movuino/maxiMotorShield/Hardware/MotorShieldV0.99.3-3.brd

## EAGLE design Hardware/MotorShieldV0.99.3-3.brd (2020-12-16)

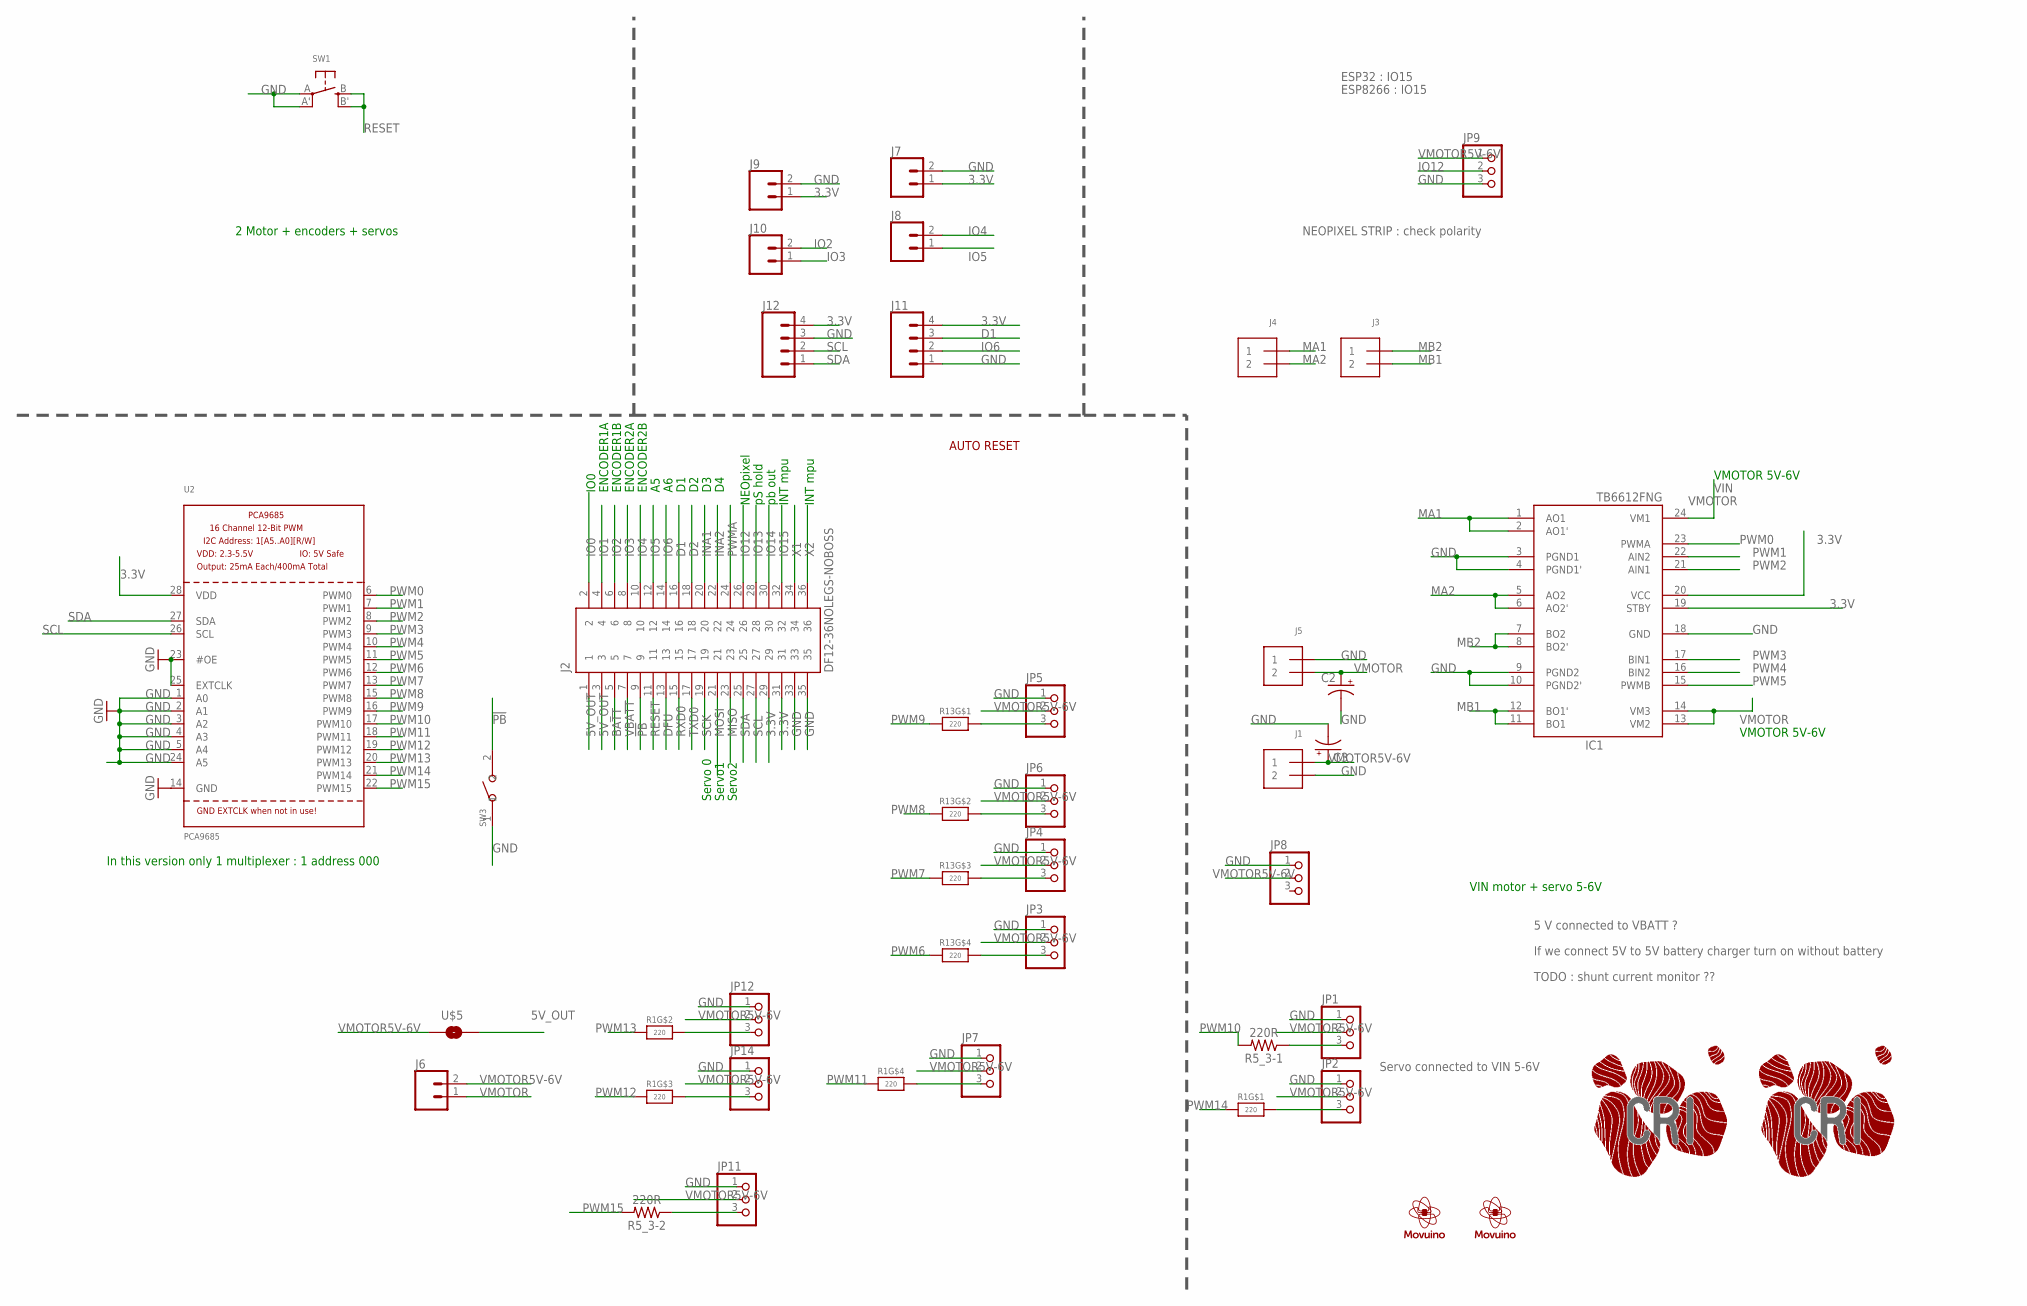
[picture p1: schematic MotorShieldV0.99.3-3.sch]

Parts:
C2, C3: CPOL-USE3.5-8; E3,5-8
IC1: TB6612FNG; SSOP24
J1, J3, J4, J5: TERMBLOCK_1X2; TERMBLOCK_1X2-3.5MM
J2: DF12-36NOLEGS-NOBOSS; DF12-36-DP-NL-NB
J6, J7, J8, J9, J10: CONN_02; 1X02
J11, J12: CONN_04; 1X04
JP1, JP2, JP3, JP4, JP5, JP6, JP7, JP8, JP9, JP11, JP12, JP14: PINHD-1X3; 1X03
R1, R13: 220; RESPACK_4X0603
R5_3-1, R5_3-2: 220R; R0402-SMALL-TDOCU
SW1: SWITCH_TACT_SMT; EVQ-Q2
SW3: DIP-BUTTON(2P-6.0X3.0X4.3MM)-TS-1101F; SW2-5.0-6.0X3.0X4.3MM
U2: PCA9685; TSSOP28
U$1: LOGO_MOVUINOTOP; LOGO_MOVUINO_BMP_10MM
U$2, U$3: LOGO-CRI-NEW-110MM-BOTTOM-SILK; LOGO_CRI-NEW-BMP10MM-BOTTOM
U$5: 0402-JUMPERCLOSED-DEFAULT; 0402-JUMPER-CLOSED
U$8: LOGO_MOVUINOBOTTOM_11MM; LOGO_MOVUINO_BMP_11MM-BOTTOM

Connections:
3.3V: IC1.19 (STBY), IC1.20 (VCC), J2.29, J2.31, J7.1, J9.1, J11.4, J12.4, U2.28 (VDD)
5V_OUT: J2.1, J2.3, U$5.2
!PB!: J2.9, SW3.2
BATT: J2.5
D1: J2.16, J11.3
D2: J2.18
DFU: J2.13
GND: C2.-, C3.-, IC1.3 (PGND1), IC1.4 (PGND1'), IC1.9 (PGND2), IC1.10 (PGND2'), IC1.18 (GND), J1.2, J2.33, J2.35, J5.1, J7.2, J9.2, J11.1, J12.3, JP1.1, JP2.1, JP3.1, JP4.1, JP5.1, JP6.1, JP7.1, JP8.1, JP9.3, JP11.1, JP12.1, JP14.1, SW1.A, SW1.A' (P1), SW3.1, U2.1 (A0), U2.2 (A1), U2.3 (A2), U2.4 (A3), U2.5 (A4), U2.14 (GND), U2.23 (#OE), U2.24 (A5), U2.25 (EXTCLK)
INA1: J2.20
INA2: J2.22
IO0: J2.2
IO1: J2.4
IO2: J2.6, J10.2
IO3: J2.8, J10.1
IO4: J2.10, J8.2
IO5: J2.12, J8.1
IO6: J2.14, J11.2
IO12: J2.26, JP9.2
IO13: J2.28
IO14: J2.30
IO15: J2.32
MA1: IC1.1 (AO1), IC1.2 (AO1'), J4.1
MA2: IC1.5 (AO2), IC1.6 (AO2'), J4.2
MB1: IC1.11 (BO1), IC1.12 (BO1'), J3.2
MB2: IC1.7 (BO2), IC1.8 (BO2'), J3.1
MISO: J2.23
MOSI: J2.21
unnamed: JP5.3, R13.8 (2)
unnamed: JP6.3, R13.7 (2)
unnamed: JP4.3, R13.6 (2)
unnamed: JP3.3, R13.5 (2)
unnamed: JP1.3, R5_3-1.1
unnamed: JP2.3, R1.8 (2)
unnamed: JP12.3, R1.7 (2)
unnamed: JP14.3, R1.6 (2)
unnamed: JP7.3, R1.5 (2)
unnamed: JP11.3, R5_3-2.1
PWM0: IC1.23 (PWMA), U2.6 (PWM0)
PWM1: IC1.22 (AIN2), U2.7 (PWM1)
PWM2: IC1.21 (AIN1), U2.8 (PWM2)
PWM3: IC1.17 (BIN1), U2.9 (PWM3)
PWM4: IC1.16 (BIN2), U2.10 (PWM4)
PWM5: IC1.15 (PWMB), U2.11 (PWM5)
PWM6: R13.4 (1), U2.12 (PWM6)
PWM7: R13.3 (1), U2.13 (PWM7)
PWM8: R13.2 (1), U2.15 (PWM8)
PWM9: R13.1, U2.16 (PWM9)
PWM10: R5_3-1.2, U2.17 (PWM10)
PWM11: R1.4 (1), U2.18 (PWM11)
PWM12: R1.3 (1), U2.19 (PWM12)
PWM13: R1.2 (1), U2.20 (PWM13)
PWM14: R1.1, U2.21 (PWM14)
PWM15: R5_3-2.2, U2.22 (PWM15)
PWMA: J2.24
RESET: J2.11, SW1.B (S), SW1.B' (S1)
RXD0: J2.15
SCK: J2.19
SCL: J2.27, J12.2, U2.26 (SCL)
SDA: J2.25, J12.1, U2.27 (SDA)
TXD0: J2.17
VBATT: J2.7
VMOTOR: C2.+, IC1.13 (VM2), IC1.14 (VM3), IC1.24 (VM1), J5.2, J6.1
VMOTOR5V-6V: C3.+, J1.1, J6.2, JP1.2, JP2.2, JP3.2, JP4.2, JP5.2, JP6.2, JP7.2, JP8.2, JP9.1, JP11.2, JP12.2, JP14.2, U$5.1
X1: J2.34
X2: J2.36

Notes on the sheet:
AUTO RESET
5 V connected to VBATT ?
If we connect 5V to 5V battery charger turn on without battery
VIN
VMOTOR 5V-6V
Servo connected to VIN 5-6V
TODO : shunt current monitor ??
ENCODER2B
ENCODER2A
ENCODER1B
ENCODER1A
IO0
NEOpixel
pS hold
pb out
INT mpu
Servo 0
Servo1
Servo2
In this version only 1 multiplexer : 1 address 000
2 Motor + encoders + servos
VIN motor + servo 5-6V
NEOPIXEL STRIP : check polarity
ESP8266 : IO15
ESP32 : IO15

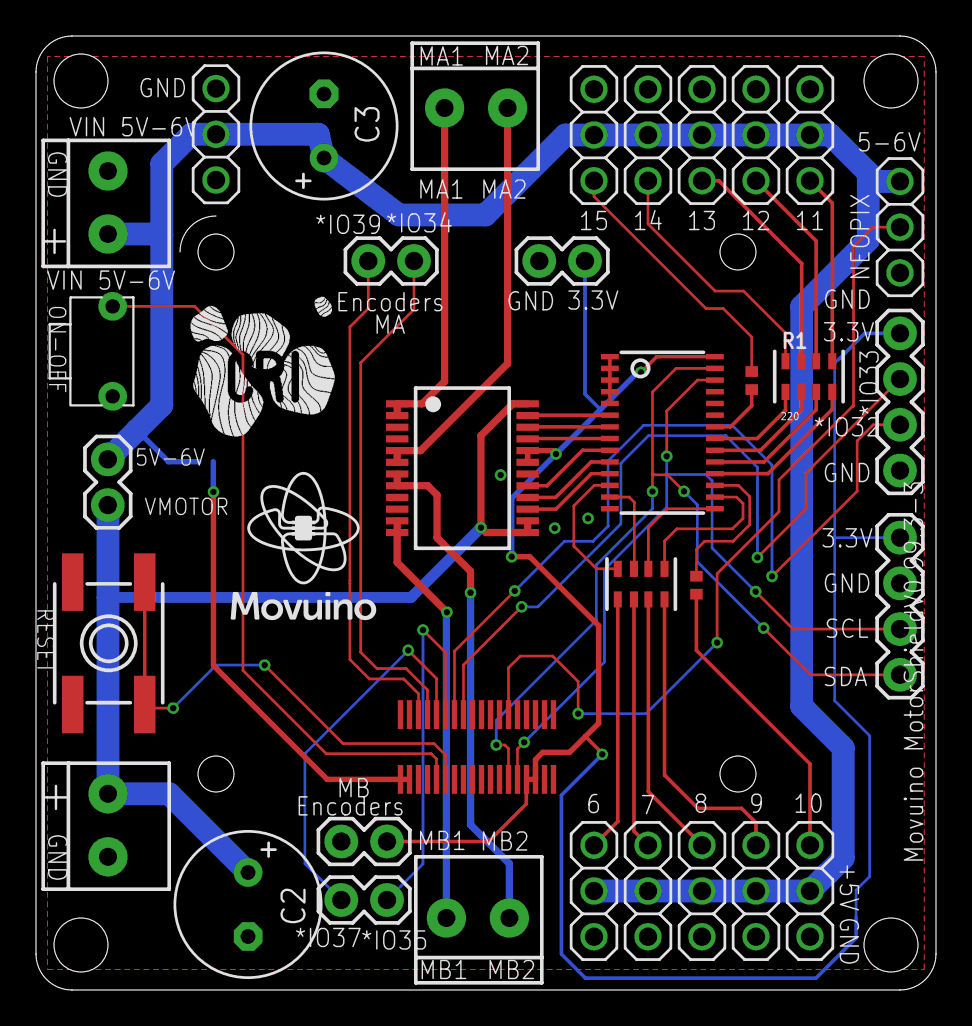
[picture p2: board MotorShieldV0.99.3-3.brd from above]

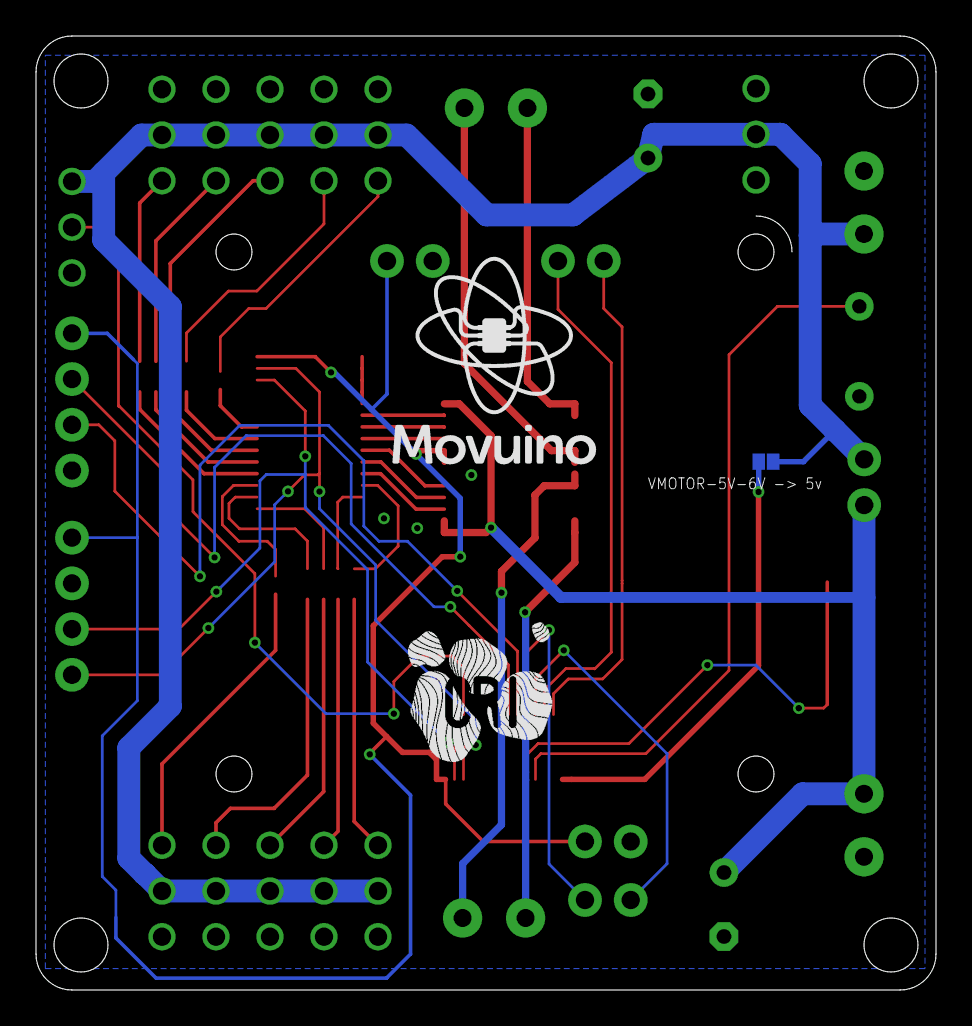
[picture p3: board MotorShieldV0.99.3-3.brd from below]

Board: 2 copper layers, 50.0 x 53.0 mm, 39 parts (2 on the bottom side), 46 nets.
